gheleguen/geodesic_dome/docs/connecteurs_a_goupilles.md

# Connecteurs à goupilles
J'ai testé plusieurs solutions pour faciliter le montage rapide d'un dôme fréquence 3. Les rotules sont très répendues mais peu utilisés pour des dômes de fréquence supérieur à 2 (comme le démontre mes essais précédents).
Je cherche donc toujours à réaliser un système facilitant la montage et le démontage. 
J'ai commencé par me tourner sur des solutions d'étoilesn en tôle. Cette solution pose le problème de la multiplication de connecteurs spécifiques. En effet, un dôme demande déjà des connecteurs à 6, 5 et 4 voie. De plus, le fait de vouloir réaliser un dôme de fréquence 3 impose d'utiliser des tasseaux de 3 longueurs différentes. Sauf que l'angle entre un tasseau et le connecteur ne dépend pas du nombre de voie de ce dernier mais bel et bien de la longueur de l'arrête. 
Ainsi j'ai préféré réaliser une solution avec une longueur de tasseau, un angle. Plutôt que multiplier les types de connecteurs. 
Ce qui m'a amené à réaliser des pièces se vissant au bout des tasseaux. Ces dernières s'imbriquent dans un connecteur et se bloque au moyen d'une goupille à ressort. 

<section style="border: 2px solid red; padding: 20px; border-radius:20px; color: red;">
Attention ! Cette solution est encore en cour de conception et n'a à ce jour pas encore été testé. </li>
</section>

**Date de début du projet :** Janvier 2024

**Date de la dernière modification :** en cours

**Etat du projet :** En prototypage

**Temps :** Une à deux semaines (temps d'impression des pièces) et  2 ou 3 jours de préparation du bois et montage

**Prérequis :** Disposer d'une imprimante 3D et des connaissances liées ainsi que de matériel pour le travail du bois.

## 1. Préparation des connecteurs

- [Retrouver tous les fichiers en question dans l'archive](https://github.com/gheleguen/geodesic_dome/tree/master/hardware/connecteurs_imbriques)

### 1.1 Impression des pièces
**A Imprimer :**
 - 25 connecteurs 6 emplacements
 - 6 connecteurs 5 emplacements
 - 15 connecteurs 4 emplacements
 - Imprimer au total 240 embout de tasseaux (100 d'une couleur pour les tasseaux longs, 80 pour les moyens et 60 pour les cours).

**Recommandations de paramétrages d'impression :**
 - **Matériau :** PETG
 - **Résolution :** 0,2mm
 - **Remplissage :** 20%
