gheleguen/geodesic_dome/docs/connecteurs_imbriques.md

# Connecteurs imbriqués
Les conecteurs imbriqués est un nouvel essais pour remplacer les connecteurs à rotules qui avaient le défaut de donner trop de libertés aux tasseaux. Pour un dôme de fréquence 3 il est plus facile de commander le montage par la périphérie. Mais dans ce cas, les tasseaux doivent rester en position et ne pas tomber. J'ai donc dessiné un système où l'on imbrique les tasseaux dans une gorge. Cet asseblage se veut rapide et contraint la structure avec un angle de 11°. Une plaque vissé sur le dessus empêchera les tasseaux de sortir des connecteurs. 

*Date de début du projet :** Octobre 2022

**Date de la dernière modification :** 24 octobre 2022

**Etat du projet :** En développement

**Temps :** Une à deux semaines (temps d'impression des pièces) et Un à 2 ou 3 jours de préparation du bois et montage

**Prérequis :** Disposer d'une imprimante 3D et des connaissances liées ainsi que de matériel pour le travail du bois.

## 1. Préparation des connecteurs

- [Retrouver tous les fichiers en question dans l'archive](https://github.com/gheleguen/geodesic_dome/tree/master/hardware/connecteurs_imbriques)

### 1.1 Impression des pièces
**A Imprimer :**
 - 25 connecteurs 6 emplacements
 - 6 connecteurs 5 emplacements
 - 15 connecteurs 4 emplacements
 - Imprimer au total 240 embout de tasseaux (100 d'une couleur pour les tasseaux longs, 80 pour les moyens et 60 pour les cours).

**Recommandations de paramétrages d'impression :**
 - **Matériau :** PETG
 - **Résolution :** 0,2mm
 - **Remplissage :** 20%
