gheleguen/geodesic_dome/hardware/connecteurs_imbriques/connecteur_5P_V3.2 v2.stl

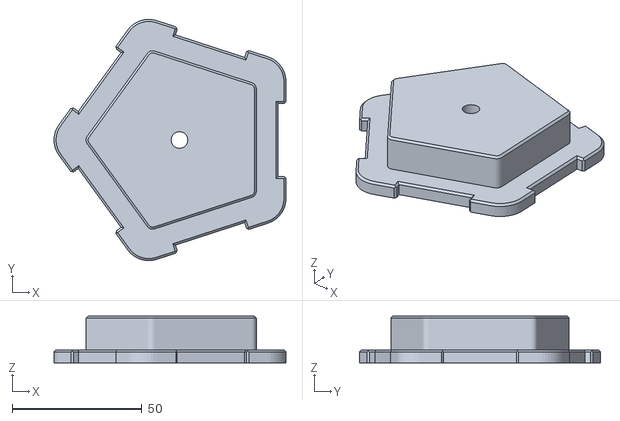
[picture p4: CAD file, 2022-10-24]
hardware/connecteurs_imbriques/connecteur_5P_V3.2 v2.stl
89.3 x 92.8 x 18.0
