gheleguen/geodesic_dome/hardware/connecteurs_imbriques/embout_tasseau_V3.2 v10.stl

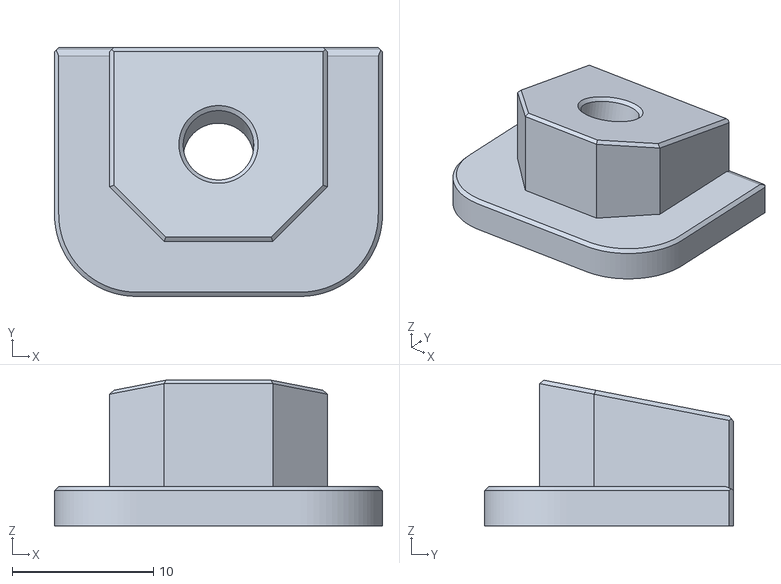
[picture p5: CAD file, 2022-10-24]
hardware/connecteurs_imbriques/embout_tasseau_V3.2 v10.stl
23.2 x 17.6 x 10.3
