gheleguen/geodesic_dome/hardware/connecteurs_imbriques/connecteur_5P_V3.2 v3.stl

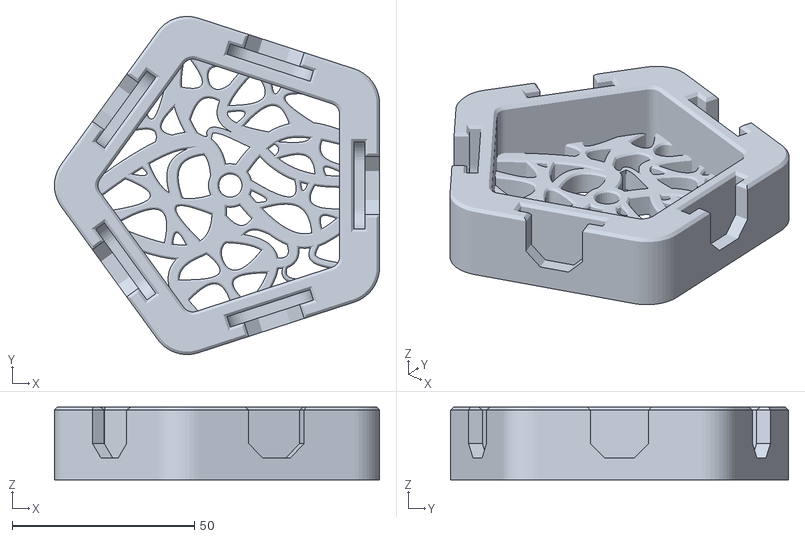
[picture p7: CAD file, 2022-10-24]
hardware/connecteurs_imbriques/connecteur_5P_V3.2 v3.stl
89.3 x 92.8 x 20.0
