gheleguen/geodesic_dome/hardware/connecteurs_imbriques/connecteur_6P_V3.2 v8.stl

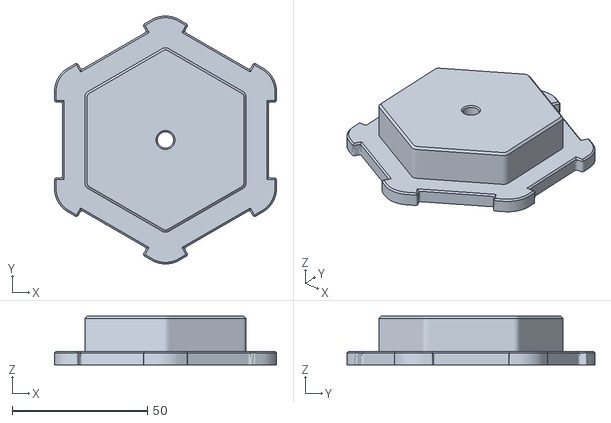
[picture p8: CAD file, 2022-10-24]
hardware/connecteurs_imbriques/connecteur_6P_V3.2 v8.stl
82.0 x 91.6 x 18.0
