gheleguen/geodesic_dome/hardware/archives_projets_abandones/connecteurs_a_rotules/domekit_gheleguen_hub_x4_down_v2.stl

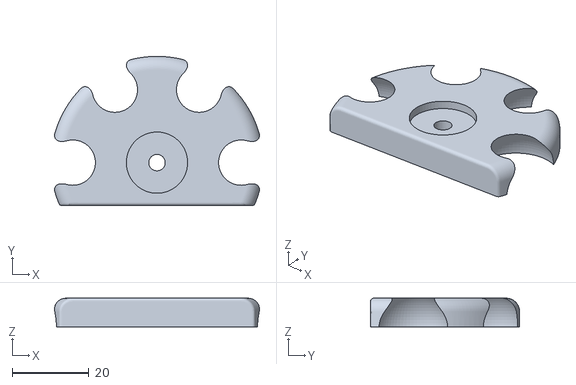
[picture p9: CAD file, 2022-10-23, an earlier design]
hardware/archives_projets_abandones/connecteurs_a_rotules/domekit_gheleguen_hub_x4_down_v2.stl
53.5 x 39.0 x 7.50
