gheleguen/geodesic_dome/hardware/archives_projets_abandones/connecteurs_a_rotules/domekit_gheleguen_hub_x5_up_v2.stl

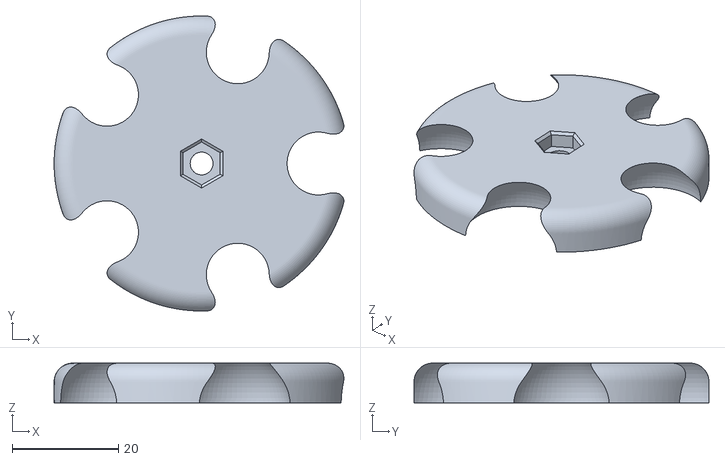
[picture p11: CAD file, 2022-10-23, an earlier design]
hardware/archives_projets_abandones/connecteurs_a_rotules/domekit_gheleguen_hub_x5_up_v2.stl
54.5 x 55.5 x 7.50
