gheleguen/geodesic_dome/hardware/archives_projets_abandones/connecteurs_a_rotules/domekit_gheleguen_ball-joint_v2.stl

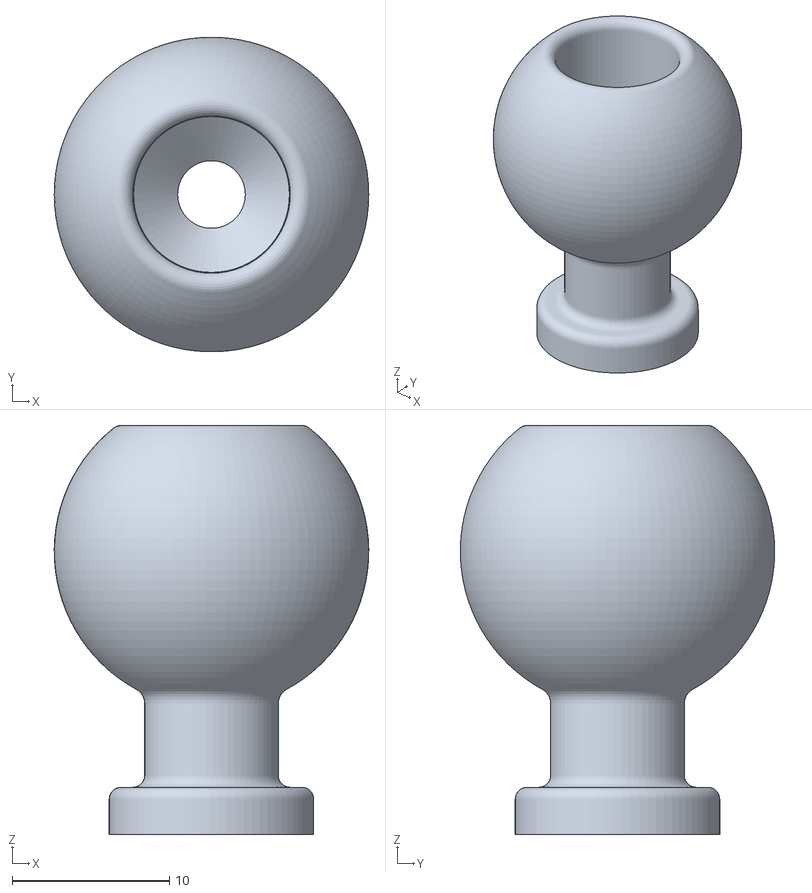
[picture p13: CAD file, 2022-10-23, an earlier design]
hardware/archives_projets_abandones/connecteurs_a_rotules/domekit_gheleguen_ball-joint_v2.stl
20.0 x 20.0 x 26.0
