gheleguen/geodesic_dome/(list of files, cad)

Other CAD files:
hardware/archives_projets_abandones/connecteurs_a_rotules/domekit_gheleguen_hub_x5_down_v2.stl
hardware/archives_projets_abandones/connecteurs_a_rotules/domekit_gheleguen_ball-joint_v2.f3d
hardware/archives_projets_abandones/connecteurs_a_rotules/domekit_gheleguen_hub_x4_down_v2.f3d
hardware/archives_projets_abandones/connecteurs_a_rotules/domekit_gheleguen_hub_x4_up_v2.f3d
hardware/archives_projets_abandones/connecteurs_a_rotules/domekit_gheleguen_hub_x5_down_v2.f3d
hardware/archives_projets_abandones/connecteurs_a_rotules/domekit_gheleguen_hub_x5_up_v2.f3d
hardware/archives_projets_abandones/connecteurs_a_rotules/domekit_gheleguen_hub_x6_down_v2.f3d
hardware/archives_projets_abandones/connecteurs_a_rotules/domekit_gheleguen_hub_x6_up_v2.f3d
