gheleguen/geodesic_dome/(commit log)

2022-10-23 Premier commit
    [domekit_gheleguen_ball-joint_v2.f3d, domekit_gheleguen_ball-joint_v2.stl, domekit_gheleguen_hub_x4_down_v2.f3d, domekit_gheleguen_hub_x4_down_v2.stl, domekit_gheleguen_hub_x4_up_v2.f3d, domekit_gheleguen_hub_x4_up_v2.stl, domekit_gheleguen_hub_x5_down_v2.f3d, domekit_gheleguen_hub_x5_down_v2.stl]
2022-10-23 zjout de la photo du dome monté
2022-10-24 Ajout du file doc des connecteurs imbriqués
    [connecteur_5P_V3.2 v2.stl, connecteur_5P_V3.2 v3.stl, connecteur_6P_V3.2 v7.stl, connecteur_6P_V3.2 v8.stl, embout_tasseau_V3.2 v10.stl]
2024-06-03 solution goupille
    [connecteur_5P_V3.2 v2.stl, connecteur_5P_V3.2 v3.stl, connecteur_6P_V3.2 v7.stl, connecteur_6P_V3.2 v8.stl, embout_tasseau_V3.2 v10.stl]
